usmanmehmood55/ESP32-Rover/KiCad Files/ESP32 Rover.kicad_pcb

## KiCad design KiCad Files/ESP32 Rover.kicad_pcb (2020-03-06, last stored version)

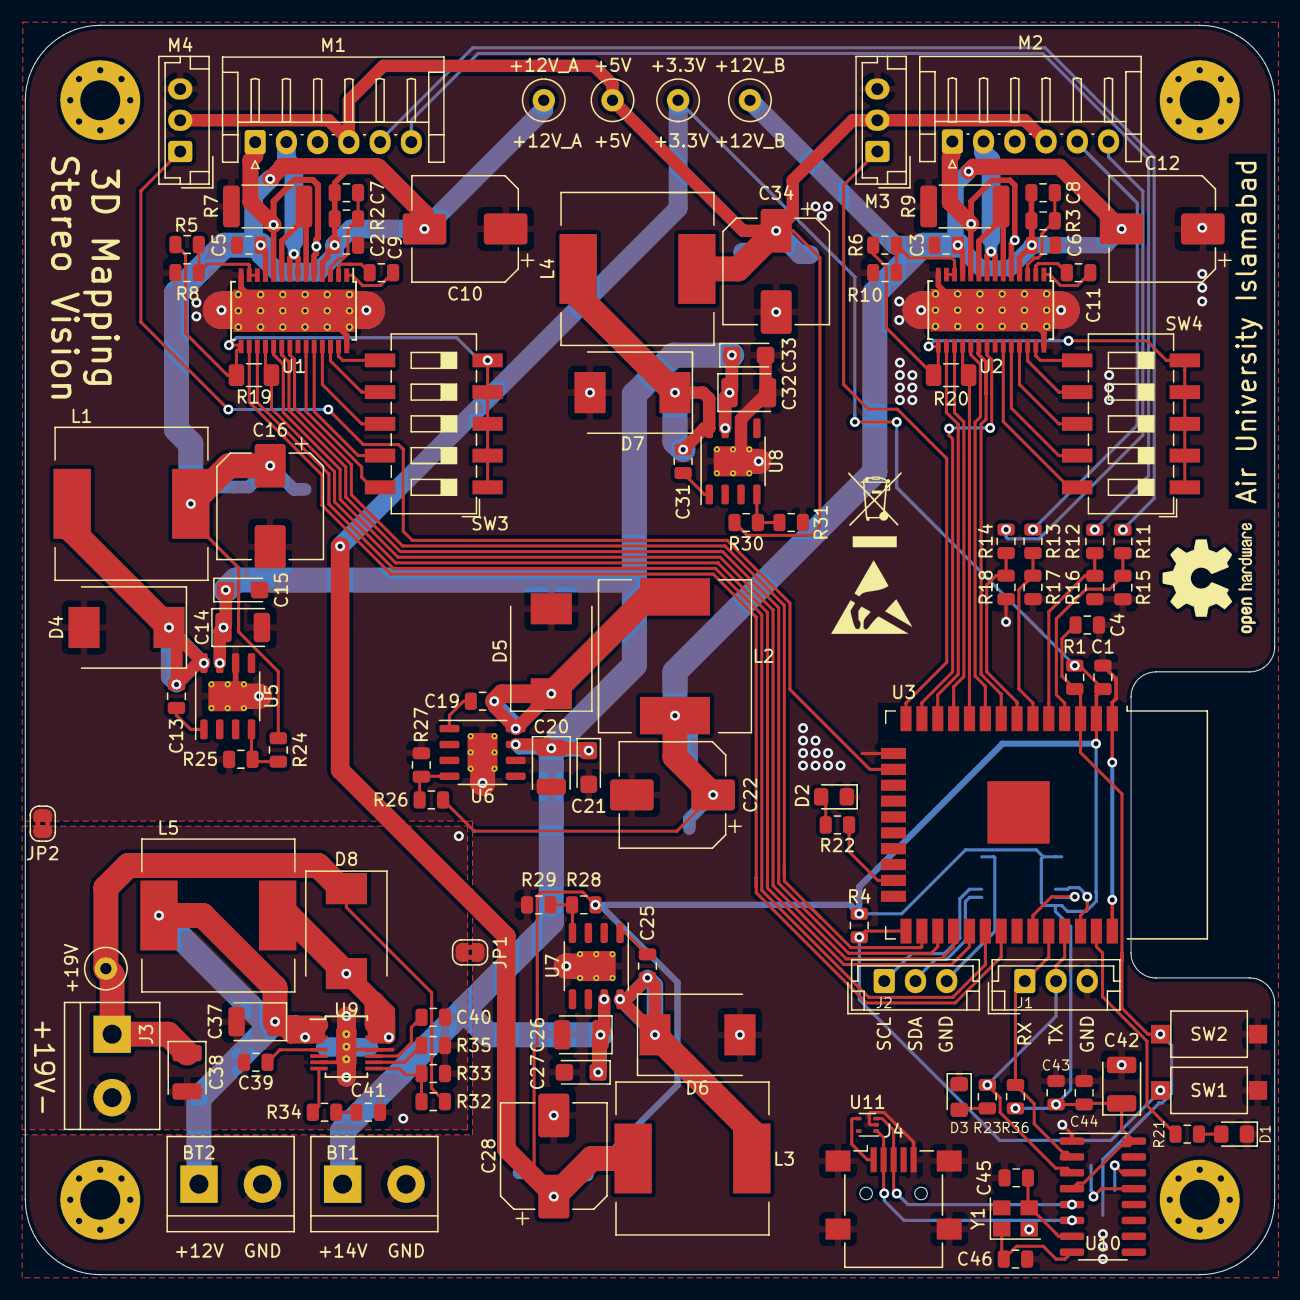
[picture p1: board ESP32 Rover.kicad_pcb from above]

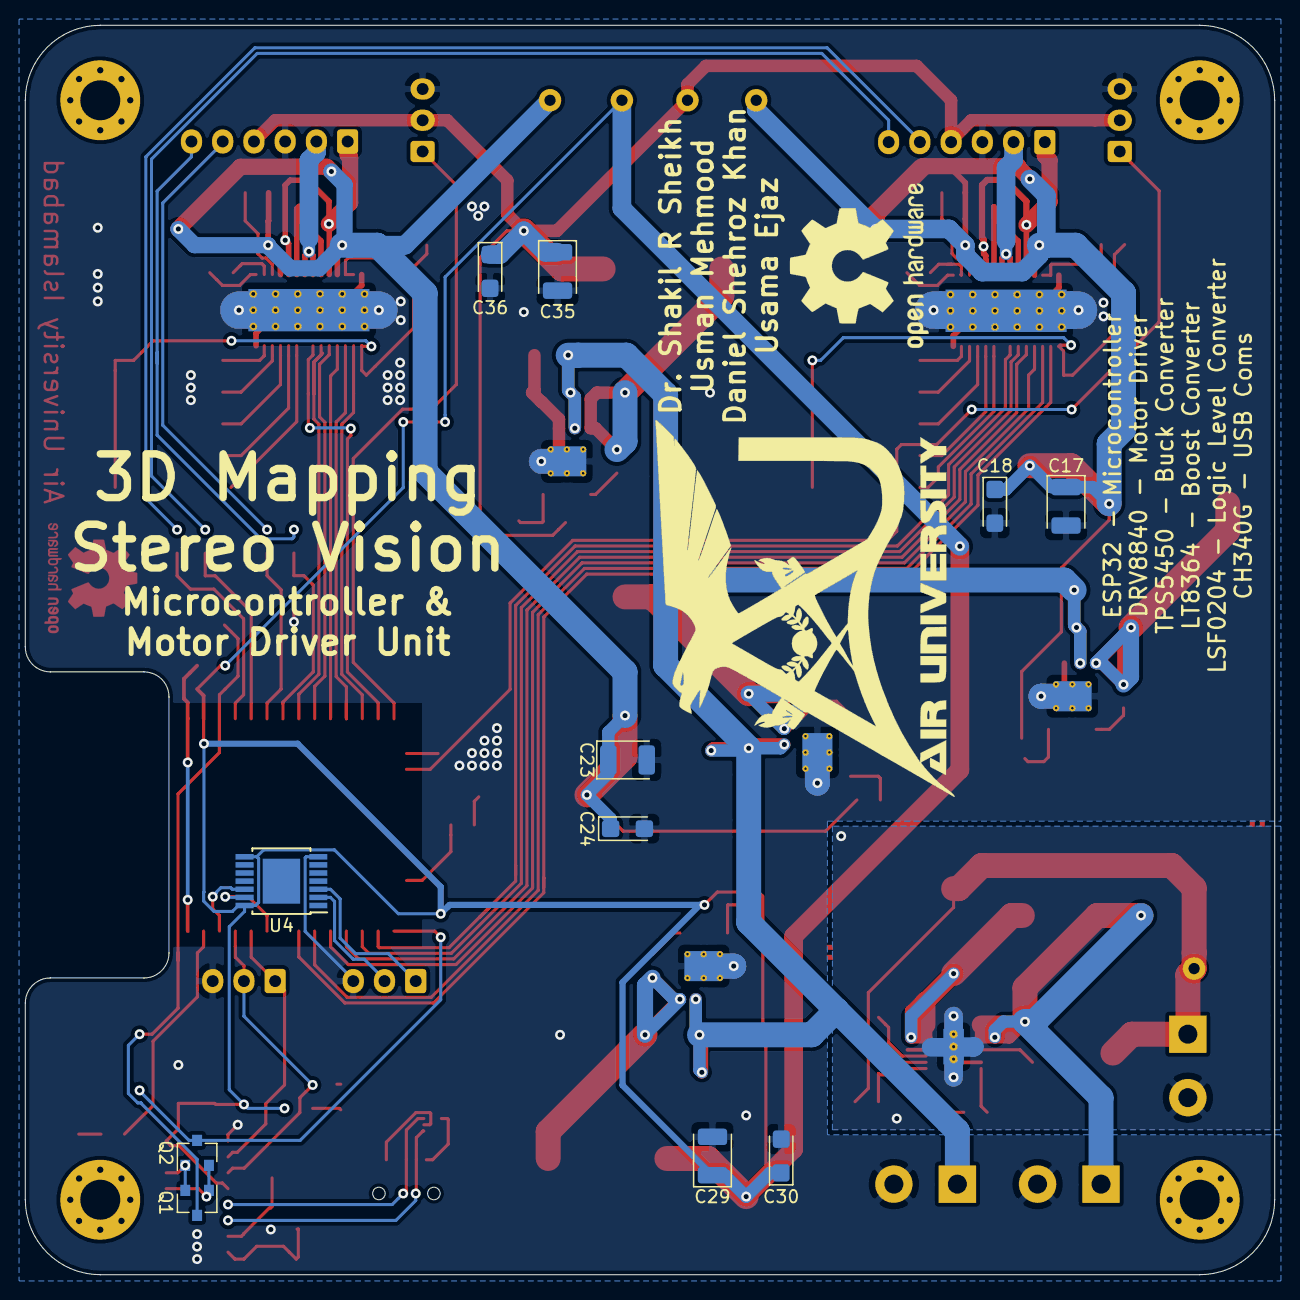
[picture p2: board ESP32 Rover.kicad_pcb from below]

Board: 2 copper layers, 100.0 x 100.0 mm, 138 parts (11 on the bottom side), 96 nets.

Parts:
BIN: BIN; WEEE-Logo_4.2x6mm_SilkScreen
BT1: 14.8V; TerminalBlock_bornier-2_P5.08mm
BT2: 11.1V; TerminalBlock_bornier-2_P5.08mm
C1, C39: 1uF; C_0805_2012Metric
C2, C3, C5, C6, C7, C8: 0.1uF; C_0805_2012Metric
C4, C9, C11, C13, C19, C25, C31, C43: 100nF; C_0805_2012Metric
C10, C12: 100uF; CP_Elec_8x10
C14, C17, C20, C23, C26, C29, C32, C35, C37, C38, C42: 4.7uF; CP_EIA-3528-15_AVX-H
C15, C18, C21, C24, C27, C30, C33, C36: 220nF; CP_EIA-3216-18_Kemet-A
C16, C22, C28, C34: 330uF; CP_Elec_8x10
C40, C44: 10nF; C_0805_2012Metric
C41: 2.2nF; C_0805_2012Metric
C45, C46: 22pF; C_0805_2012Metric
D1, D2, D3: LED; LED_0805_2012Metric_Pad1.15x1.40mm_HandSolder
D4, D5, D6, D7, D8: 5A; D_SMC
ESD: ESD; ESD-Logo_6.6x6mm_SilkScreen
H1, H2, H3, H4: MH; MountingHole_3.2mm_M3_Pad_Via
J1: UART; JST_EH_B3B-EH-A_1x03_P2.50mm_Vertical
J2: i2c_jetson; JST_EH_B3B-EH-A_1x03_P2.50mm_Vertical
J3: T-Block; TerminalBlock_bornier-2_P5.08mm
J4: USB_B_Mini; USB_Mini-B_Lumberg_2486_01_Horizontal
JP1, JP2: SolderJumper_2_Bridged; SolderJumper-2_P1.3mm_Bridged2Bar_RoundedPad1.0x1.5mm
L1, L2, L3, L4: 15uH; L_Pulse_PA4320
L5: 2.4uH; L_Pulse_PA4320
M1, M2: PL37D; JST_EH_S6B-EH_1x06_P2.50mm_Horizontal
M3, M4: Servo; JST_EH_B3B-EH-A_1x03_P2.50mm_Vertical
OSHW: OSHW; OSHW-Logo2_9.8x8mm_SilkScreen
OSHW#2: OSHW; OSHW-Logo2_9.8x8mm_Copper
Q1, Q2: BSS138; SOT-23
R1, R4, R5, R6, R24, R25, R26, R27, R28, R29, R30, R31: 10K; R_0805_2012Metric
R2, R3: 1M; R_0805_2012Metric
R7, R9: 0.1R; R_2512_6332Metric
R8, R10: 31K; R_0805_2012Metric
R11, R12, R13, R14: 1K; R_0805_2012Metric
R15, R16, R17, R18: 2K; R_0805_2012Metric
R19, R20: 10K; R_1206_3216Metric
R21, R22, R23: 83; R_0805_2012Metric
R32: 10k; R_0805_2012Metric
R33: 100k; R_0805_2012Metric
R34: 36.5k; R_0805_2012Metric
R35: 20k; R_0805_2012Metric
R36: 4.7K; R_0805_2012Metric
SW1: BOOT/FLASH; SW_SPST_CK_RS282G05A3
SW2: RESET; SW_SPST_CK_RS282G05A3
SW3, SW4: iChop; SW_DIP_SPSTx05_Slide_6.7x14.26mm_W8.61mm_P2.54mm_LowProfile
TP1: +12V_A; TestPoint_Loop_D2.60mm_Drill0.9mm_Beaded
TP2: +12V_B; TestPoint_Loop_D2.60mm_Drill0.9mm_Beaded
TP3: +3.3V; TestPoint_Loop_D2.60mm_Drill0.9mm_Beaded
TP4: +5V; TestPoint_Loop_D2.60mm_Drill0.9mm_Beaded
TP5: +19V; TestPoint_Loop_D2.60mm_Drill0.9mm_Beaded
U1, U2: DRV8840; HTSSOP-28-1EP_4.4x9.7mm_P0.65mm_EP3.4x9.5mm_Mask2.4x6.17mm_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
U3: ESP32-WROOM-32D; ESP32-WROOM-32
U4: LSF0204; TSSOP-14-1EP_4.4x5mm_P0.65mm
U5, U6, U7, U8: TPS5450; HSOP-8-1EP_3.9x4.9mm_P1.27mm_EP2.41x3.1mm_ThermalVias
U9: LT8364; MSOP-12-16-1EP_3x4mm_P0.5mm_EP1.65x2.85mm_ThermalVias
U10: CH340G; SOIC-16_3.9x9.9mm_P1.27mm
U11: ESDA6V8AV5; SOT-553
Y1: 12MHz; Crystal_SMD_3225-4Pin_3.2x2.5mm

Connections:
3P3_1: R5.1, R19.1, SW3.1, SW3.2, SW3.3, SW3.4, SW3.5, U1.15
3P3_2: R6.1, R20.1, SW4.1, SW4.2, SW4.3, SW4.4, SW4.5, U2.15
+3V3: C1.1, C28.1, C29.1, C30.1, C42.1, C43.1, C44.1, L3.2, R1.1, R4.1, R28.1, R36.1, TP3.1, U3.2, U4.8, U4.14, U10.4, U10.16
+5V: C34.1, C35.1, C36.1, L4.2, M1.4, M2.4, M3.2, M4.2, R30.1, TP4.1
+12V: BT2.1, C37.1, L5.1, U9.1, U9.3
/M1+: M1.1, U1.5, U1.10
/M1-: M1.2, U1.7, U1.8
/M2+: M2.1, U2.5, U2.10
/M2-: M2.2, U2.7, U2.8
BOOT: Q2.3, R4.2, SW1.1, U3.25
D+: J4.3, U10.5, U11.3
D-: J4.2, U10.6, U11.1
DTR: Q1.1, Q2.2, U10.13
EC1A: R11.2, R15.1, U3.4
EC1B: R12.2, R16.1, U3.5
EC2A: R13.2, R17.1, U3.6
EC2B: R14.2, R18.1, U3.7
EN: C4.1, Q1.3, R1.2, SW2.1, U3.3
ENC1A: M1.5, R11.1
ENC1B: M1.6, R12.1
ENC2A: M2.5, R13.1
ENC2B: M2.6, R14.1
GND: BT1.2, BT2.2, C1.2, C2.1, C3.1, C4.2, C5.1, C6.1, C10.1, C12.1, C14.2, C15.2, C16.2, C17.2, C18.2, C20.2, C21.2, C22.2, C23.2, C24.2, C26.2, C27.2, C28.2, C29.2, C30.2, C32.2, C33.2, C34.2, C35.2, C36.2, C42.2, C43.2, C44.2, C45.2, C46.2, D1.1, D2.1, D3.1, D4.2, D5.2, D6.2, D7.2, J1.3, J2.3, J4.5, J4.6, JP1.1, JP2.1, M1.3, M2.3, M3.3, M4.3, R7.2, R8.2, R9.2, R10.2, R15.2, R16.2, R17.2, R18.2, R25.2, R27.2, R29.2, R31.2, SW1.2, SW2.2, U1.14, U1.28, U1.29, U2.14, U2.28, U2.29, U3.1, U3.15, U3.38, U4.7, U5.6, U5.9, U6.6, U6.9, U7.6, U7.9, U8.6, U8.9, U10.1, U11.2, Y1.2, Y1.4
GNDD: C37.2, C38.2, C39.2, C40.2, C41.2, J3.2, JP1.2, JP2.2, R33.2, R35.1, U9.7, U9.12, U9.17
M1C0: SW3.10, U1.23
M1C1: SW3.9, U1.24
M1C2: SW3.8, U1.25
M1C3: SW3.7, U1.26
M1C4: SW3.6, U1.27
M1DECAY: U1.19, U3.28
M1FAULT: R19.2, U1.18, U3.29
M1PHASE: U1.20, U3.27
M1PWM: U1.21, U3.26
M1RST: U1.16, U3.31
M1SLEEP: U1.17, U3.30
M2C0: SW4.10, U2.23
M2C1: SW4.9, U2.24
M2C2: SW4.8, U2.25
M2C3: SW4.7, U2.26
M2C4: SW4.6, U2.27
M2DECAY: U2.19, U3.9
M2FAULT: R20.2, U2.18, U3.10
M2PHASE: U2.20, U3.8
M2PWM: U2.21, U3.13
M2RST: U2.16, U3.12
M2SLEEP: U2.17, U3.11
unnamed: C7.2, R2.2, U1.3
unnamed: C8.2, R3.2, U2.3
unnamed: C9.1, U1.1
unnamed: C9.2, U1.2
unnamed: C11.1, U2.1
unnamed: C11.2, U2.2
unnamed: C13.1, D4.1, L1.1, U5.8
unnamed: C13.2, U5.1
unnamed: C19.1, D5.1, L2.1, U6.8
unnamed: C19.2, U6.1
unnamed: C25.1, D6.1, L3.1, U7.8
unnamed: C25.2, U7.1
unnamed: C31.1, D7.1, L4.1, U8.8
unnamed: C31.2, U8.1
unnamed: C39.1, U9.5
unnamed: C40.1, U9.11
unnamed: C41.1, R34.2
unnamed: D1.2, R21.2
unnamed: D2.2, R22.2
unnamed: D3.2, R23.2
unnamed: D8.2, L5.2, U9.14, U9.16
unnamed: R5.2, R8.1, U1.12, U1.13
unnamed: R7.1, U1.6, U1.9
unnamed: R9.1, U2.6, U2.9
unnamed: R6.2, R10.1, U2.12, U2.13
unnamed: R32.2, R33.1, U9.9
unnamed: R34.1, U9.8
unnamed: R35.2, U9.10
O1: C45.1, U10.7, Y1.3
O2: C46.1, U10.8, Y1.1
RTS: Q1.2, Q2.1, U10.14
RX: J1.1, R36.2, U3.34, U10.2
SCL: U3.36, U4.12
SCL1: J2.1, U4.3
SDA: U3.33, U4.13
SDA1: J2.2, U4.2
SRV1: M3.1, U3.14
SRV2: M4.1, U3.16
STAT1: R21.1, U3.37
STAT2: R22.1, U3.23
TX: J1.2, R23.1, U3.35, U10.3
VBUS: J4.1, U11.4
VDC: BT1.1, C14.1, C15.1, C20.1, C21.1, C26.1, C27.1, C32.1, C33.1, U5.7, U6.7, U7.7, U8.7
VSNS1: R24.2, R25.1, U5.4
VSNS2: R26.2, R27.1, U6.4
VSNS3: R28.2, R29.1, U7.4
VSNS4: R30.2, R31.1, U8.4
V_SoC: C38.1, D8.1, J3.1, R32.1, TP5.1
vMotor1: C2.2, C5.2, C7.1, C10.2, C16.1, C17.1, C18.1, L1.2, R2.1, R24.1, TP1.1, U1.4, U1.11
vMotor2: C3.2, C6.2, C8.1, C12.2, C22.1, C23.1, C24.1, L2.2, R3.1, R26.1, TP2.1, U2.4, U2.11
