usmanmehmood55/ESP32-Rover/(commit log)

2020-03-08 Remove duplicated directory
    [ESP32 Rover.kicad_pcb, ESP32 Rover.sch, ESP32_Rover.xlsx, ESP32_Rover_export.xlsx, PowerSupply.sch, USB Comms.sch]
2020-06-05 Motor functions altered
2020-06-06 motorBehaviour function added
2020-07-11 encoder code ongoing
